MiSaKa100039/USB-SATA_huawei3.5x3/pcb/Pannel/ver0.3/README.md

2025/12/29

1.修改jms578上拉外部参考电阻上拉为下拉，修改了不能识别USB3.0的bug

2.更换jsm578外部电感，修改了电感饱和电流过小导致芯片重启的bug

3.移动xh254端子位置，防止和贴片电容位置干涉

4.移动读写LED位置与亚克力导光条对齐
