MiSaKa100039/USB-SATA_huawei3.5x3/pcb/Pannel/ver0.3/Pannel3.5x3/Project Outputs for Pannel3.5x3/Pannel3.5x3_Ver0.3_BOM.xlsx

Comment | Description | Designator | Footprint | LibRef | Quantity
100nF 50V | 无极性贴片电容 | C1, C2, C3, C4, C6, C8, C15, C16, C17, C128, C130, C132, C139, C140, C142 | C0402_L | C | 15
22uF 10V | 无极性贴片电容 | C5 | C0805_L | C | 1
22uF 25V | 无极性贴片电容 | C7, C129, C131, C141 | C0805_L | C | 4
150PF 50V | 无极性贴片电容 | C9 | C0402_L | C | 1
68PF 50V | 无极性贴片电容 | C10, C134, C143 | C0402_L | C | 3
22uF 10V | 无极性贴片电容 | C11, C13, C135, C137, C144 | C0603_L | C | 5
10nF 6.3V | 无极性贴片电容 | C18, C19, C20, C21, C22, C23, C24, C25, C26, C27, C28, C29 | C0402_L | C | 12
1uF 10V | 无极性贴片电容 | C30, C31, C36, C37, C74, C77 | C0402_L | C | 6
10uF 6.3V | 无极性贴片电容 | C32, C34, C75 | C0603_L | C | 3
100nF 6.3V | 无极性贴片电容 | C33, C35, C38, C39, C40, C41, C42, C43, C44, C45, C46, C47, C48, C49, C50, C51, C52, C53, C54, C55, C56, C57, C58, C59, C60, C61, C62, C63, C64, C65, C66, C67, C68, C69, C76, C78, C79, C80, C81, C82, C83, C84, C85, C86, C87, C88, C89, C90, C91, C92, C93, C97, C98, C99, C100, C101, C102, C103, C104, C105, C106, C107, C110, C111, C112, C113, C114, C115, C116, C117, C118, C119, C120, C121, C122, C123, C124, C125, C126 | C0402_L | C | 79
33pF/16V | 无极性贴片电容 | C70, C71, C72, C73, C94, C95 | C0402_L | C | 6
100nF 10V | 无极性贴片电容 | C96 | C0402_L | C | 1
22pF/16V | 无极性贴片电容 | C108, C109 | C0402_L | C | 2
1nF 25V | 无极性贴片电容 | C127 | C0402_L | C | 1
56PF 50V | 无极性贴片电容 | C133 | C0402_L | C | 1
3.5*1.3 | 低压电源接口 | CON1 | DC-012 | P-DC | 1
47uF/16V | 贴片电解电容 | E1, E2, E3, E4, E5, E6, E7, E8 | CS 6*4 - R | C-CD | 8
220uF/10V | 贴片电解电容 | E9, E10, E11, E12, E13 | CS 6*4 - B | C-CD | 5
SATA15P |  | J1, J2, J3 | SATA 15P 贴片 | SATA15P | 3
TYPEC-501S-ACP24H92 | USB-C (USB TYPE-C) USB 3.2 Gen 2 (USB 3.1 Gen 2, Superspeed + (USB 3.1)) Receptacle Connector 24 Position Surface Mount, Right Angle; Through Hole | J4 | TypeC 24p 直立 | Typec 24p | 1
USB3.1_Type-A | USB接口 | J5 | USB3.1_Type-A 立式直插 | USB3.1_Type-A | 1
HDR-1X2 | 2P接插件 | JP1 | ZH1.5-WS-2P | Header 2 | 1
HDR-1X2 | 2P接插件 | JP2 | XH2.54-WS-2P | Header 2 | 1
1.5uH | 小功率贴片电感 | L1 | SMMS0420 | L | 1
10uH | 小功率贴片电感 | L2, L7, L8 | SMMS0420 | L | 3
4.7uH | 小功率贴片电感 | L3, L4, L5, L6 | SMMS0420 | L | 4
blue | 插件LED | LED3, LED5, LED7 | LED 0805B | LED-3MM | 3
green | 插件LED | LED4, LED6, LED8 | LED 0805G | LED-3MM | 3
MARK1.6 | 光学定位点 | MR1, MR2, MR3, MR4 | Mark 1 | MARK | 4
Pmos_SOP8 | Pmos_SOP8 | Q1 | SOP8_L | Pmos_SOP8 | 1
100K 1% | 贴片电阻 | R1, R2, R5, R6, R10, R30, R31, R36 | R0402_L | R | 8
66.5K 1% | 贴片电阻 | R3 | R0402_L | R | 1
13.7K 1% | 贴片电阻 | R4, R9, R12 | R0402_L | R | 3
22.1K 1% | 贴片电阻 | R7 | R0402_L | R | 1
10K 1% | 贴片电阻 | R8, R11, R38, R39, R45, R53 | R0402_L | R | 6
4.7K 1% | 贴片电阻 | R20, R21, R22, R23, R24, R25, R28, R29, R35, R40, R41, R42, R43, R44, R48, R50, R52, R54, R55 | R0402_L | R | 19
330K 1% | 贴片电阻 | R26, R27, R34 | R0402_L | R | 3
12K 1% | 贴片电阻 | R32, R33, R37 | R0402_L | R | 3
20K 1% | 贴片电阻 | R46, R47 | R0402_L | R | 2
12.4k 1% | 贴片电阻 | R49 | R0402_L | R | 1
1M 1% | 贴片电阻 | R51 | R0402_L | R | 1
TPS54202DDCR | DCDC Convert | U1, U2, U14, U15, U16 | SOT23-6L | TPS54202DDCR | 5
JMS578 |  | U3, U4, U7 | QFN48-L6.0-W6.0-P0.4 | JMS578 | 3
P25Q21H |  | U5, U6, U8, U13 | SOP8_L | P25D40H | 4
VL160 |  | U9 | MQFN-28_L4.5-W3.5-P0.40-BL-EP | VL160 | 1
VL822 Q7 |  | U10 | QFN-76_L9.0-W9.0-P0.40-EP6.3-TL | VL822 Q7 | 1
TPD4E02B04 | ESD | U11, U12 | DIO_TPD4E02B04DQAR | TPD4E02B04 | 2
30Mhz |  | Y1, Y2, Y3 | OSC 3225-4P | Crystal | 3
25Mhz |  | Y4 | OSC 3225-4P | Crystal | 1
