MiSaKa100039/USB-SATA_huawei3.5x3/pcb/Pannel/ver0.3/Pannel3.5x3/STEP/Pannel3.5x3.DXF

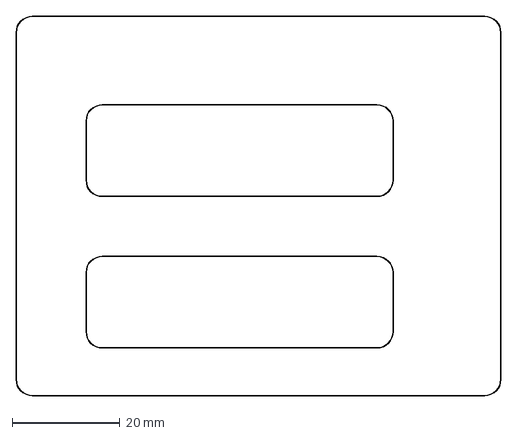
[picture p1: CAD file, 2025-09-06]
pcb/Pannel/ver0.3/Pannel3.5x3/STEP/Pannel3.5x3.DXF
90.0 x 70.4 mm
