MiSaKa100039/USB-SATA_huawei3.5x3/(list of files, drawings)

Other design files:
pcb/Pannel/ver0.1/Pannel.eprj
pcb/Pannel/ver0.2/Pannel3.5x3/connector.SchDoc
pcb/Pannel/ver0.2/Pannel3.5x3/jmb575.SchDoc
pcb/Pannel/ver0.2/Pannel3.5x3/Pannel3.5x3.PcbDoc
pcb/Pannel/ver0.2/Pannel3.5x3/pwr.SchDoc
pcb/Pannel/ver0.2/Pannel3.5x3/vl822.SchDoc
pcb/Pannel/ver0.3/Pannel3.5x3/connector.SchDoc
pcb/Pannel/ver0.3/Pannel3.5x3/jmb575.SchDoc
pcb/Pannel/ver0.3/Pannel3.5x3/Pannel3.5x3.PcbDoc
pcb/Pannel/ver0.3/Pannel3.5x3/Pannel3.5x3.PrjPcb
pcb/Pannel/ver0.3/Pannel3.5x3/pwr.SchDoc
pcb/Pannel/ver0.3/Pannel3.5x3/vl822.SchDoc
