MiSaKa100039/USB-SATA_huawei3.5x3/(commit log)

2025-08-30 原理图更新
    [Pannel.eprj, Pannel3.5x3.PcbDoc, Pannel3.5x3.PrjPcb, connector.SchDoc, jmb575.SchDoc, pwr.SchDoc, vl822.SchDoc]
2025-08-31 1.原理图绘制完成 2.pcb初步布局
    [Pannel.eprj, Pannel3.5x3.DXF, Pannel3.5x3.PrjPcb, connector.SchDoc, jmb575.SchDoc, pwr.SchDoc, vl822.SchDoc]
2025-09-03 jms578&mp8757布局
    [connector.SchDoc, jmb575.SchDoc, pwr.SchDoc, vl822.SchDoc]
2025-09-04 电源布局
    [Pannel3.5x3.PrjPcb, connector.SchDoc, jmb575.SchDoc, vl822.SchDoc]
2025-09-05 打板测试
    [Pannel3.5x3.PrjPcb, connector.SchDoc, pwr.SchDoc]
2025-09-06 V0.1提交打板
    [Pannel3.5x3.DXF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]
2025-09-07 更改电感封装为2520
    [Pannel3.5x3.DRL, Pannel3.5x3.GBL, Pannel3.5x3.GBO, Pannel3.5x3.GBP, Pannel3.5x3.GBS, Pannel3.5x3.GM1, Pannel3.5x3.GTL, Pannel3.5x3.GTO]
2025-09-08 1.更改mos封装
    [Pannel3.5x3.GBL, Pannel3.5x3.GBO, Pannel3.5x3.GBP, Pannel3.5x3.GBS, Pannel3.5x3.GM1, Pannel3.5x3.GTL, Pannel3.5x3.GTO, Pannel3.5x3.GTP]
2025-09-30 Ver0.2打板
    [Pannel3.5x3.DRL, Pannel3.5x3.GBL, Pannel3.5x3.GBO, Pannel3.5x3.GBP, Pannel3.5x3.GBS, Pannel3.5x3.GM1, Pannel3.5x3.GTL, Pannel3.5x3.GTO]
2025-12-29 2025/12/29
    1.修改jms578上拉外部参考电阻上拉为下拉，修改了不能识别USB3.0的bug
    2.更换jsm578外部电感，修改了电感饱和电流过小导致芯片重启的bug
    3.移动xh254端子位置，防止和贴片电容位置干涉
    4.移动读写LED位置与亚克力导光条对齐
    [Pannel3.5x3.DXF, Pannel3.5x3.PcbDoc, Pannel3.5x3.PrjPcb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]
2026-01-01 2025/12/29
    5.修改5V网络为独立网络，修复了热插拔时导致设备重启的bug
    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
    [Pannel3.5x3.DRL, Pannel3.5x3_Copper_Signal_1.gbr, Pannel3.5x3_Copper_Signal_2.gbr, Pannel3.5x3_Copper_Signal_Bot.gbr, Pannel3.5x3_Copper_Signal_Top.gbr, Pannel3.5x3_Legend_Bot.gbr, Pannel3.5x3_Legend_Top.gbr, Pannel3.5x3_Mechanical_1.gbr]
2026-01-11 备份 Signed-off-by: MiSaKa100039 <3452960144@qq.com>
    [Pannel3.5x3.PcbDoc, Pannel3.5x3.PrjPcb, Pannel3.5x3_Ver0.3_BOM.xlsx, Pick Place for Pannel3.5x3.csv, connector.SchDoc, pwr.SchDoc, vl822.SchDoc]
